pommelstrike/pom360_camera/docs/bill-of-materials.md

# Bill of Materials — RV Gearbox

Bearings + fasteners for the 3D-printed RV (planetary–cycloidal) reducer. These are
**motor-independent** — adapting to a NEMA 17 removes none of them. Printed parts are in
[../STL/](../STL); part dimensions are in [technical-description.md](technical-description.md).
Structured data: [../bom/hardware.csv](../bom/hardware.csv).

| Item | Qty |
|---|---:|
| **15×24×5 bearing** | 9 |
| **20×27×4 bearing** | 3 |
| **45×58×7 bearing** | 1 |
| **M5×12 button-head screw** | 12 |
| **M5×20 button-head screw** | 4 |
| **M5 nylock nut** | 16 |
| **M3×8 socket-cap screw** | 4 |
| **M3×10 cap screw** | 4 |
| **M3×16 cap screw** | 4 |
| **M3×20 cap screw** | 4 |
| **M3×25 cap screw** | 4 |
| **M3 heat-set insert** | 16 |
| **M3×6 set screw (grub)** | 1 |

> Tip: an **M3 assortment box** (×6–×25) and an **M5 pack** cover all the screw lengths in one buy.
> Bearings come cheapest in 10-packs.

### Bearing roles

- **45×58×7 (×1)** — main output-hub bearing.
- **15×24×5 (×9)** — cycloidal roller/pin bearings.
- **20×27×4 (×3)** — seat the three eccentric cams.

See [print-settings.md](print-settings.md) for fabrication and [assembly-guide.md](assembly-guide.md)
for the build order.
