pommelstrike/pom360_camera/STL/Cycloidal_Standoff.stl

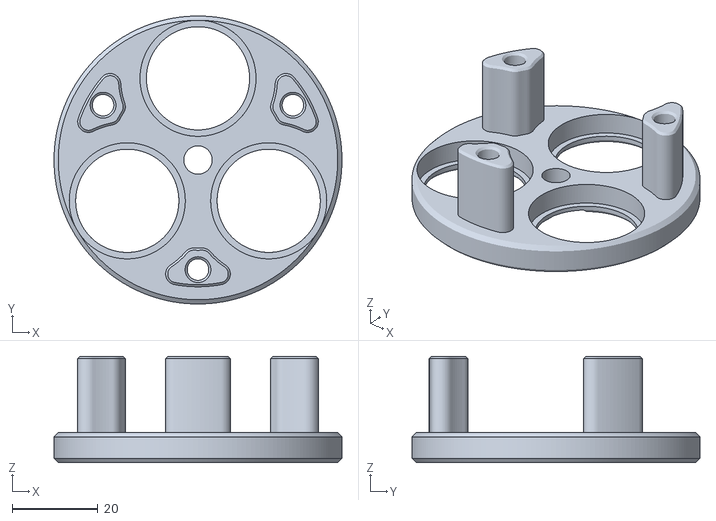
[picture p1: CAD file, 2026-06-25]
STL/Cycloidal_Standoff.stl
67.0 x 67.0 x 24.7
