pommelstrike/pom360_camera/STL/End_Cap.stl

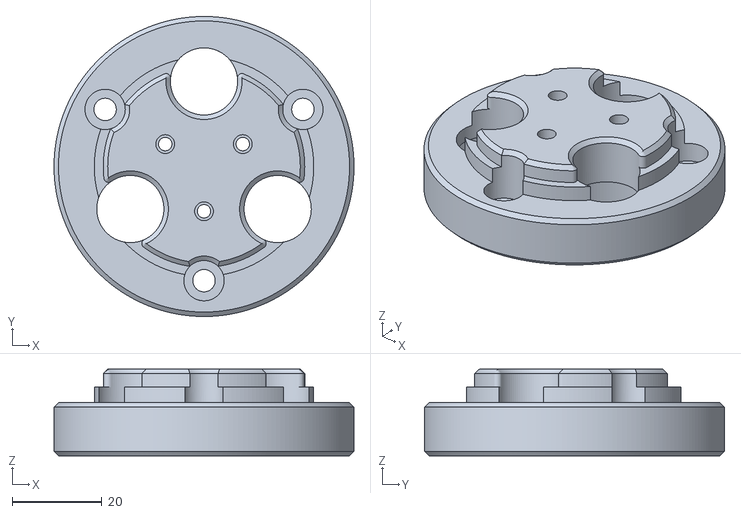
[picture p2: CAD file, 2026-06-25]
STL/End_Cap.stl
67.0 x 67.0 x 19.4
