pommelstrike/pom360_camera/STL/Hub_Retainer.stl

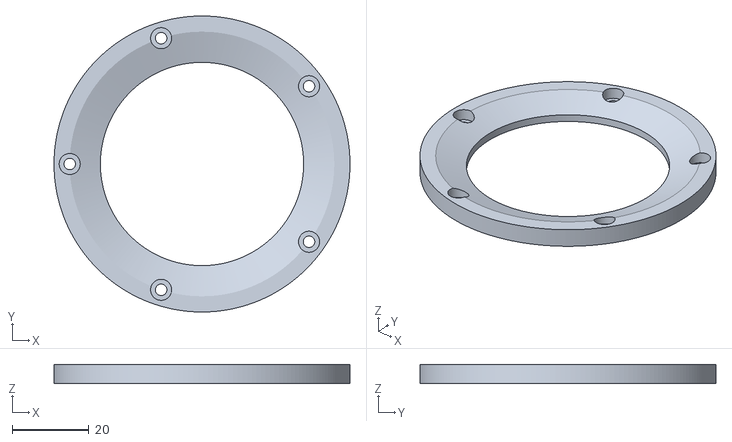
[picture p4: CAD file, 2026-06-25]
STL/Hub_Retainer.stl
77.2 x 77.2 x 5.00
