pommelstrike/pom360_camera/STL/Gearbox_Base_Closed.stl

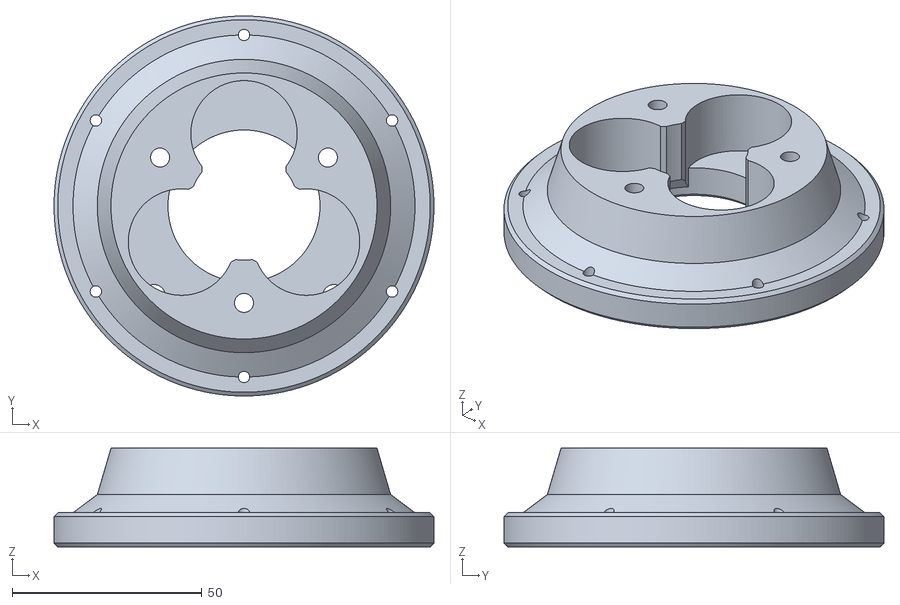
[picture p5: CAD file, 2026-06-25]
STL/Gearbox_Base_Closed.stl
100.0 x 100.0 x 26.0
