pommelstrike/pom360_camera/STL/Cycloidal_Disk_1.stl

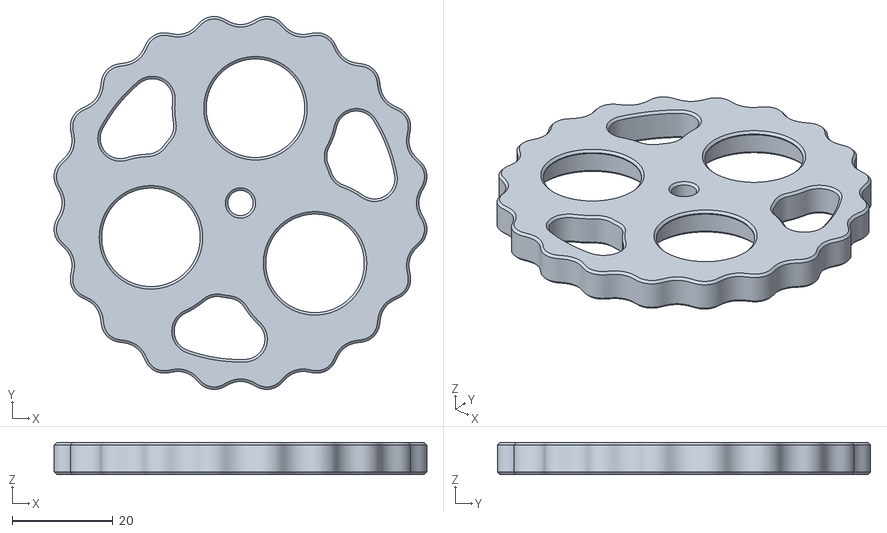
[picture p6: CAD file, 2026-06-25]
STL/Cycloidal_Disk_1.stl
73.9 x 73.9 x 6.35
