pommelstrike/pom360_camera/STL/Sun_Gear_NEMA17.stl

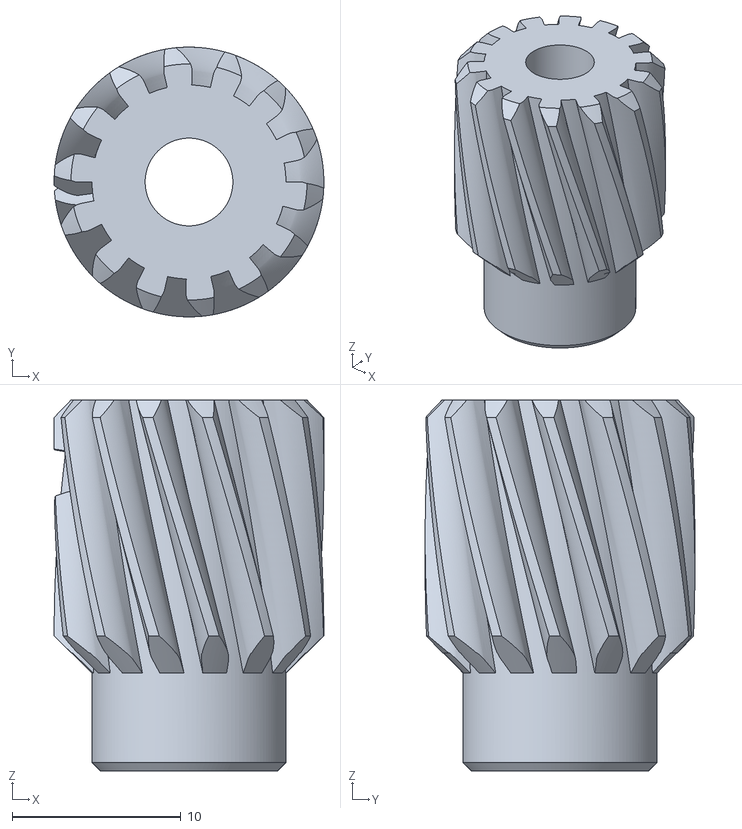
[picture p7: CAD file, 2026-06-25]
STL/Sun_Gear_NEMA17.stl
16.0 x 16.0 x 22.0
