pommelstrike/pom360_camera/STL/Adapter_NEMA17_to_NEMA23.stl

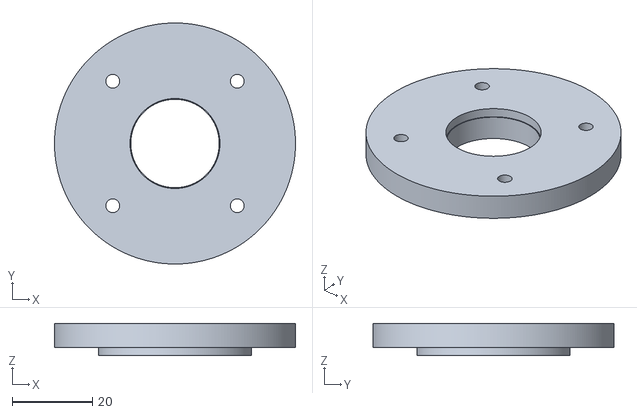
[picture p8: CAD file, 2026-06-25]
STL/Adapter_NEMA17_to_NEMA23.stl
60.0 x 60.0 x 8.00
