pommelstrike/pom360_camera/STL/Eccentric_Cam_2.stl

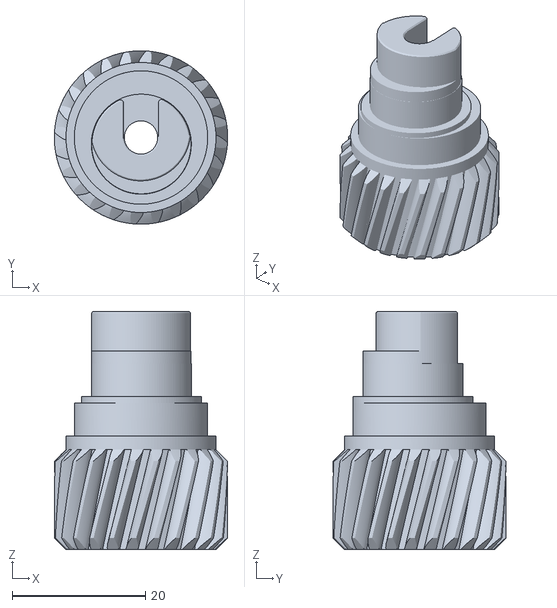
[picture p9: CAD file, 2026-06-25]
STL/Eccentric_Cam_2.stl
26.0 x 26.0 x 35.7
