pommelstrike/pom360_camera/STL/Hub_Cap.stl

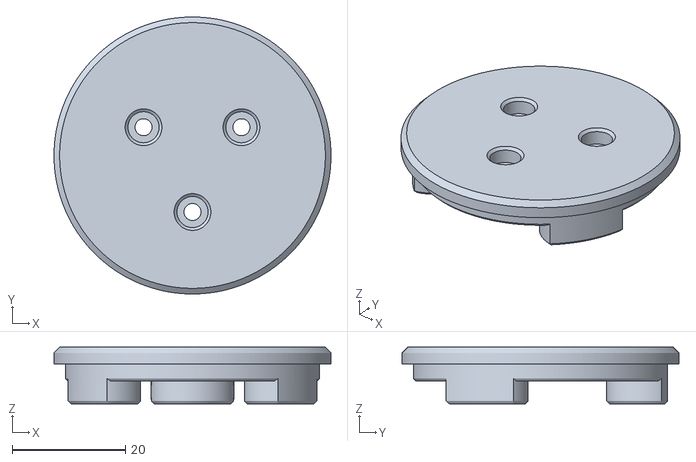
[picture p10: CAD file, 2026-06-25]
STL/Hub_Cap.stl
49.0 x 49.0 x 10.0
