pommelstrike/pom360_camera/STL/Cam_Cap.stl

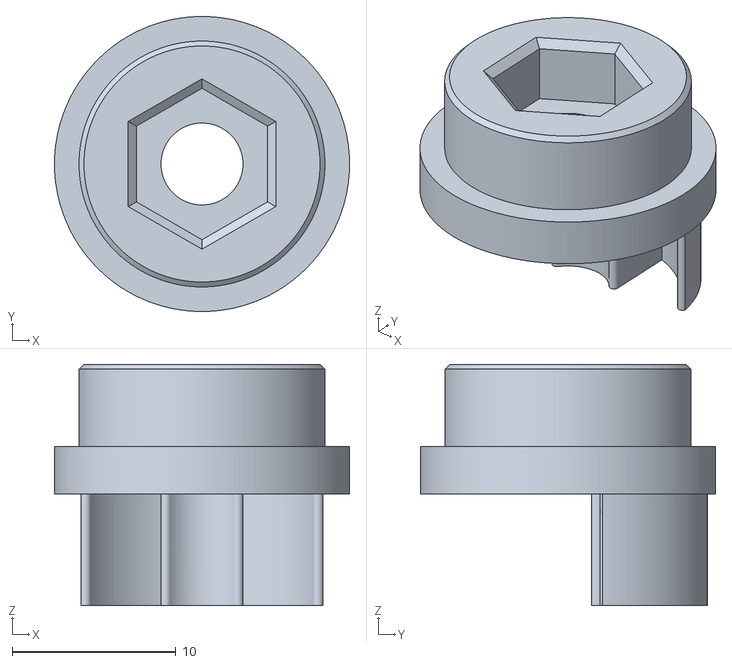
[picture p11: CAD file, 2026-06-25]
STL/Cam_Cap.stl
18.0 x 18.0 x 14.7
