pommelstrike/pom360_camera/(list of files, cad)

Other CAD files:
STL/Cycloidal_Disk_2.stl
STL/Eccentric_Cam_1.stl
